jaimealbapastor/ArtBot-Drawing_Arduino_Robot/README.md

# ArtBot - Projet Arduino Peip2

Projet réalisé dans le cadre de la formation de prépa intégrée de Polytech Nice Sophia.

### Équipe:

- **Jaime Alba Pastor** ([Profil-GitHub](https://github.com/jaimealbapastor))
- **Adrien Boichis** ([Profil-GitHub](https://github.com/Adrien295))

### Tuteurs:

- **Pascal Masson**
- **M. Peter**
- **Mme. Benouakta**

## Présentation

ArtBot est un robot destiné à l'automatisation des dessins. Il peut être utilisé pour diverses taches comme par exemple:

- Impression de documents
- Illustrer
- Signer à distance
- Tracer des graphiques

Grâce l'utilisation de l'encre de stylo bic, le côut d'impression est significativement réduit ainsi que sa maintenance.
