jaimealbapastor/ArtBot-Drawing_Arduino_Robot/Documentation/Liens_utiles.md

### Projets année dernière

- https://github.com/LeoDeLaFuente/Slam_Arduino_Bot
- http://www.sofiahub.unice.fr/arduino-projet-2017-2018/

### Exemple de très haut niveau

https://www.youtube.com/watch?v=5492ZjivAQ0

### Modèle d'inspiration

https://www.arnabkumardas.com/topics/cnc/how-to-make-an-arduino-drawing-machine/
https://github.com/arnabdasbwn/grbl-coreXY-servo

### Comparaison avec CoreXY robot

http://www.doublejumpelectric.com/projects/core_xy/2014-07-15-core_xy/

### Onshape drawing machine

https://cad.onshape.com/documents/33bfda9cab8382ac132318b2/w/66322888e1b4e86c180d445c/e/0e587b7e1299ff8f6fe98d1c

## Serial communication
https://fazecast.github.io/jSerialComm/javadoc/com/fazecast/jSerialComm/SerialPort.html
https://www.tabnine.com/code/java/methods/com.fazecast.jSerialComm.SerialPort/writeBytes
https://stackoverflow.com/questions/25502517/send-string-from-java-to-arduino-simple-example
https://sourceforge.net/projects/javaarduinolibrary/
https://forum.arduino.cc/t/arduino-reset-upon-serial-java-connection/176121/4
https://forum.arduino.cc/t/stop-reboot-on-serial-connection-how/370507/5
https://playground.arduino.cc/Main/DisablingAutoResetOnSerialConnection/
