jaimealbapastor/ArtBot-Drawing_Arduino_Robot/Documentation/Matériel.md

# Matériel utilisé

## Composants

- Servo Moteurs (x2)
- Moteur pas à pas NEMA 17 (x2) --> alimenté en 12V, 20 N/cm, pas 1,8º
- Driver A4988 (x2) pour NEMA 17
- Boutons pour indicateur de limite (x4)

## Materiel à garder intacte 

- tiges en acier inoxidable 
- roulements (6, 4 sur les pièces qui bougent qur y et deux qui se situent en y = max)
- courroie dentée
- vises pour les socles 
- planche en bois

## Parties a travailler 

### Parties qui ne bougent pas 

 - socle en bois qui contient de quoi tenir les tiges en acier, tout le set up electronique en y = 0, et les deux step moteurs  qui se situent aux deux extrémités  
 - les deux socles aux extrémités en y = max 

### Parties qui bougent sur l'axe y 

- deux petits socles en bois qui bougent sur les tiges en acier grace a des roulemenrs qui sont dessus et par l'action des moteurs qui sont en y = 0 

### Parties qui bougent sur l'axe x

- socle qui va bouger avec le stylo, notament avec le system en bois qui va contenir les 4 stylos (rouge, vert, bleu, noir) et qui va bouger a la fois en hauteur pour ecrire et qui va se tourner pour changer de couleur
