jaimealbapastor/ArtBot-Drawing_Arduino_Robot/More/Useless/EXPLICATION.md

# Développement du code source avec PlatformIO

Pour ce projet on utilise le pluggin **PlatformIO** de Visual Studio Code au lieu de l'IDE Arduino.  

## Avantages
- Toutes les fonctionnalités de l'IDE Arduino sont intégrées
- Les fichiers .c++ et .h sont mieux organisés
- Permet de build et upload directement dans la plaque arduino
- Debuggeur intégré
- Donne la doc des fonctions pendant qu'on code

## Pour se retrouver
Le code principal est dans le [dossier "src"](ArtBot_Code/src) : **[main.cpp](ArtBot_Code/src/main.cpp)**  
Les classes .h et .cpp sont dans le **[dossier "include"](ArtBot_Code/include)**  
Les librairies utilisées sont dans le **[dossier "lib"](ArtBot_Code/lib)**
