jaimealbapastor/ArtBot-Drawing_Arduino_Robot/More/Modelisation_Pieces/pièce1.md

# Première pièce

[pièce y = 0](https://cad.onshape.com/documents/21a7f2e1a193b40d7dea2639/w/ac2afb2342f08798c6df94d4/e/5c67bcf19085cbfb5db68b73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)

[pièce y = max](https://cad.onshape.com/documents/21a7f2e1a193b40d7dea2639/w/ac2afb2342f08798c6df94d4/e/a18741164f335a244cec516a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)

[pièce qui bouge sur y](https://cad.onshape.com/documents/21a7f2e1a193b40d7dea2639/w/ac2afb2342f08798c6df94d4/e/8383617883dbb1d0f51e6f5b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)

[debut de l'assemblage](https://cad.onshape.com/documents/21a7f2e1a193b40d7dea2639/w/ac2afb2342f08798c6df94d4/e/ba21421cad73b33d512d3d27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)
