jaimealbapastor/ArtBot-Drawing_Arduino_Robot/Documentation/Présentation/ArtBot.pptx

## Projet ArtBot

Par Jaime Alba Pastor et Adrien Boichis

## OBJECTIFS INITIAUX

1. Pouvoir dessiner tout type de forme. Ex: graphiques, signatures…
2. Pouvoir illustrer des documents non vides pour ajouter de la valeur ou de l’information.
3. Une option moins coûteuse qu’une imprimante classique.
4. Facilement transportable.

## CIRCUIT ELECTRONIQUE ENSEMBLE MECANIQUE LE CODE CONCLUSION ET DEMO PRESENTATION DU PROJET 01 03 02 04

Modélisation, assemblage et améliorations

Composants et problèmes rencontrés

Ce que le projet nous a apporté et continuation

Idéation, méthodes principales…

## ENSEMBLE MECANIQUE

Matériel utilisé:
- Arduino Uno
- 2 Moteurs NEMA-17
- 2 Drivers A4988
- Micro Servo Moteur
- Une courroie dentée
- 6 roulements dentés
- 6 roulements à mouvement linéaire
- Visses
- Planche de bois
- Blocs de bois

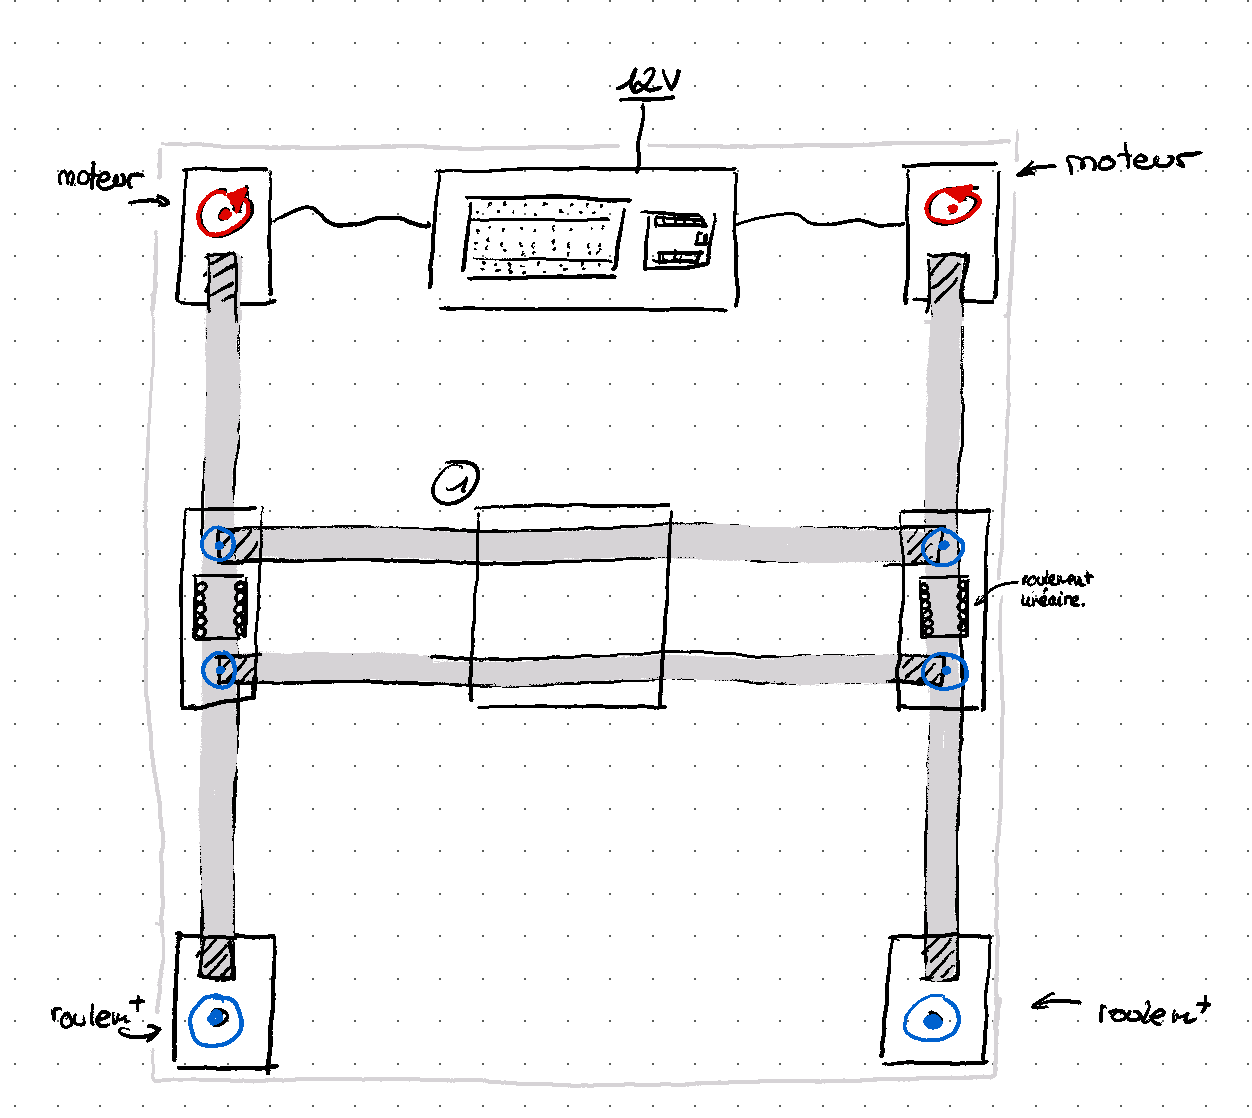
[picture p13: figure]

## FONCTIONNEMENT


## PROBLEMES RENCONTRES

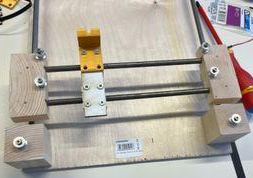
[picture p14: figure]
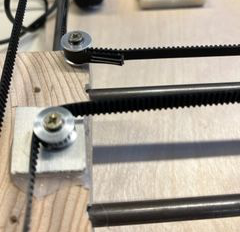
[picture p15: figure]
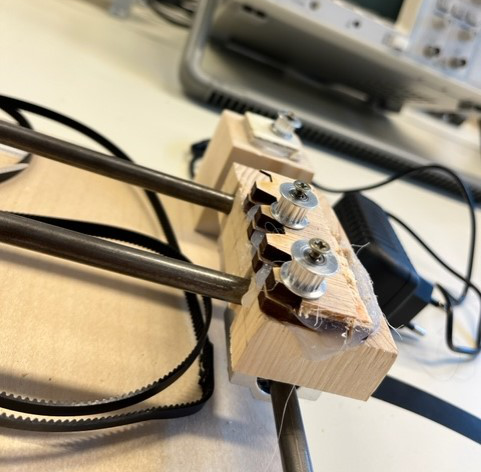
[picture p16: figure]

## CIRCUIT ELECTRONIQUE

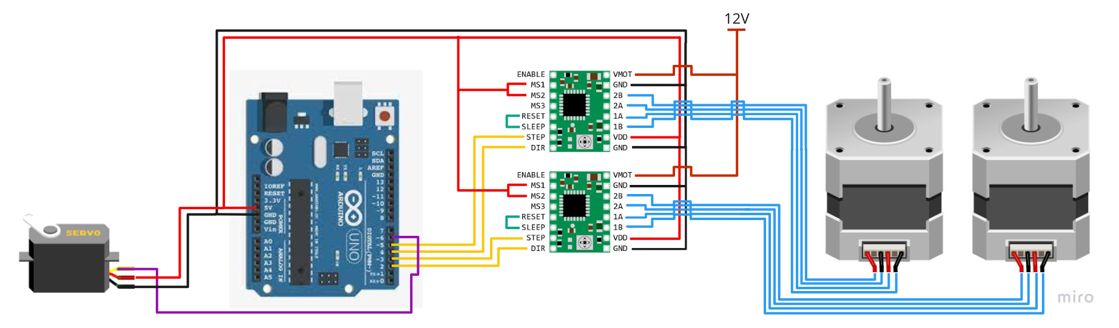
[picture p17: figure]

## LE CODE

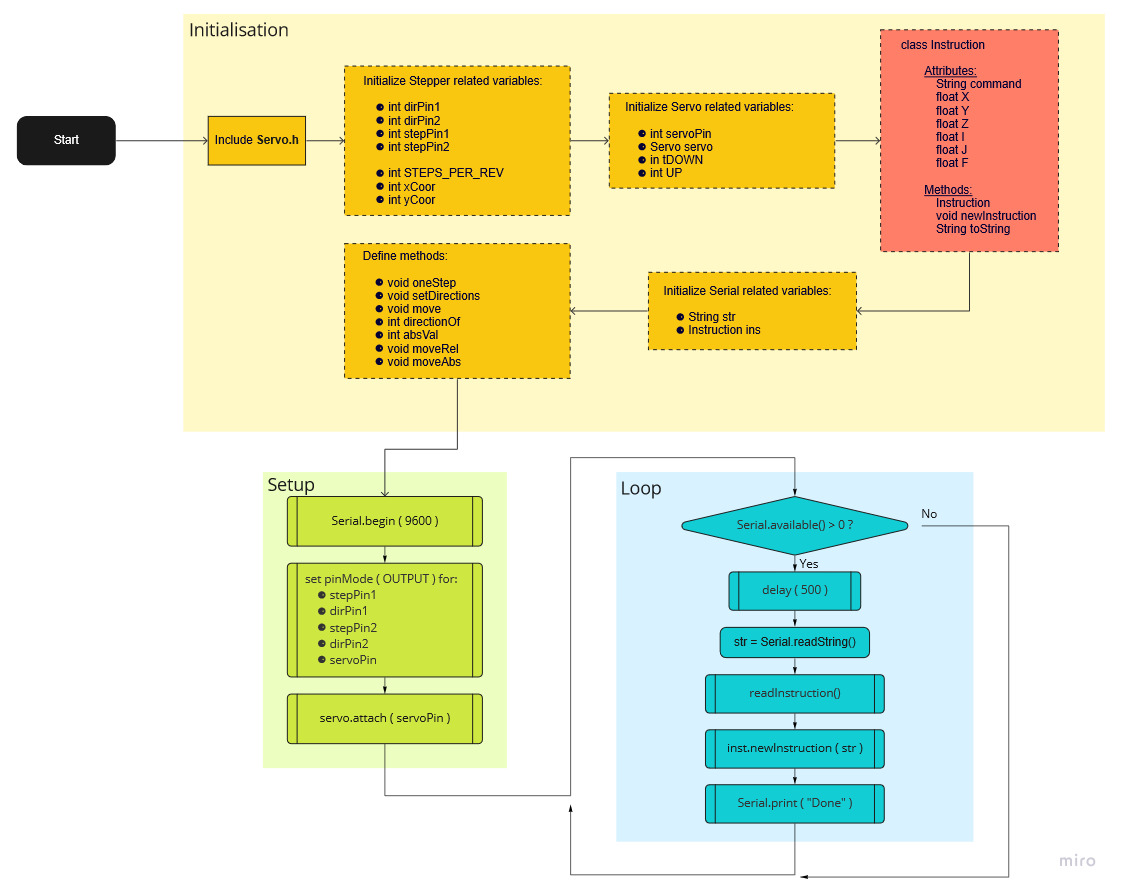
[picture p18: figure]

## Slide 9

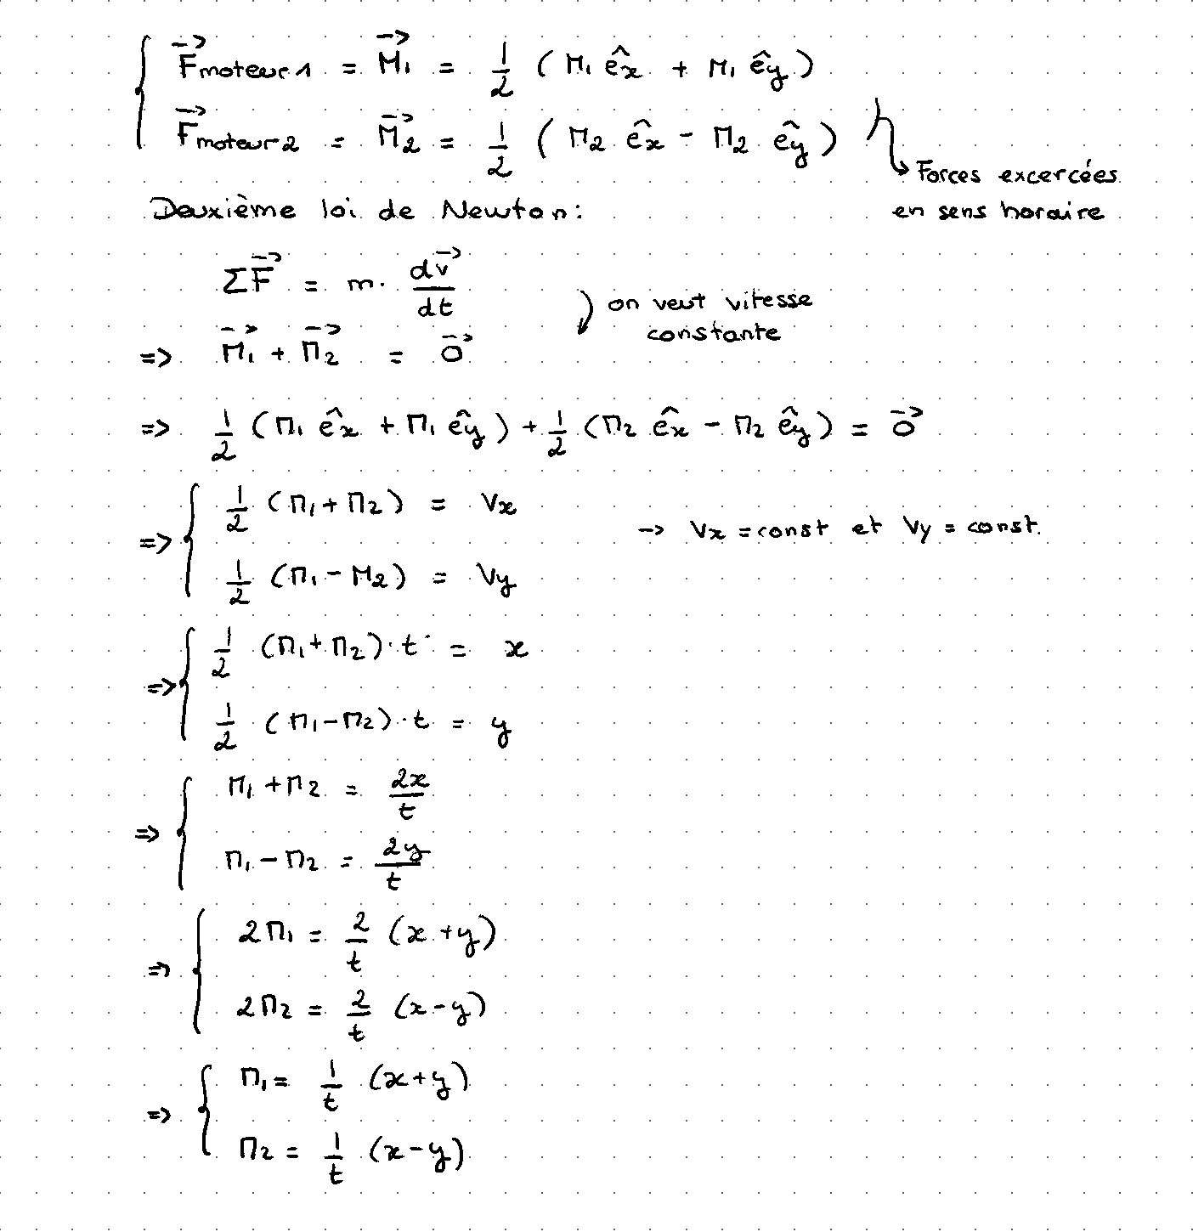
[picture p19: figure]

## APPLICATION JAVA

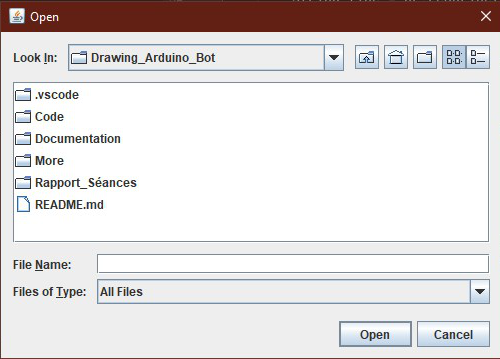
[picture p20: figure]

## Slide 11

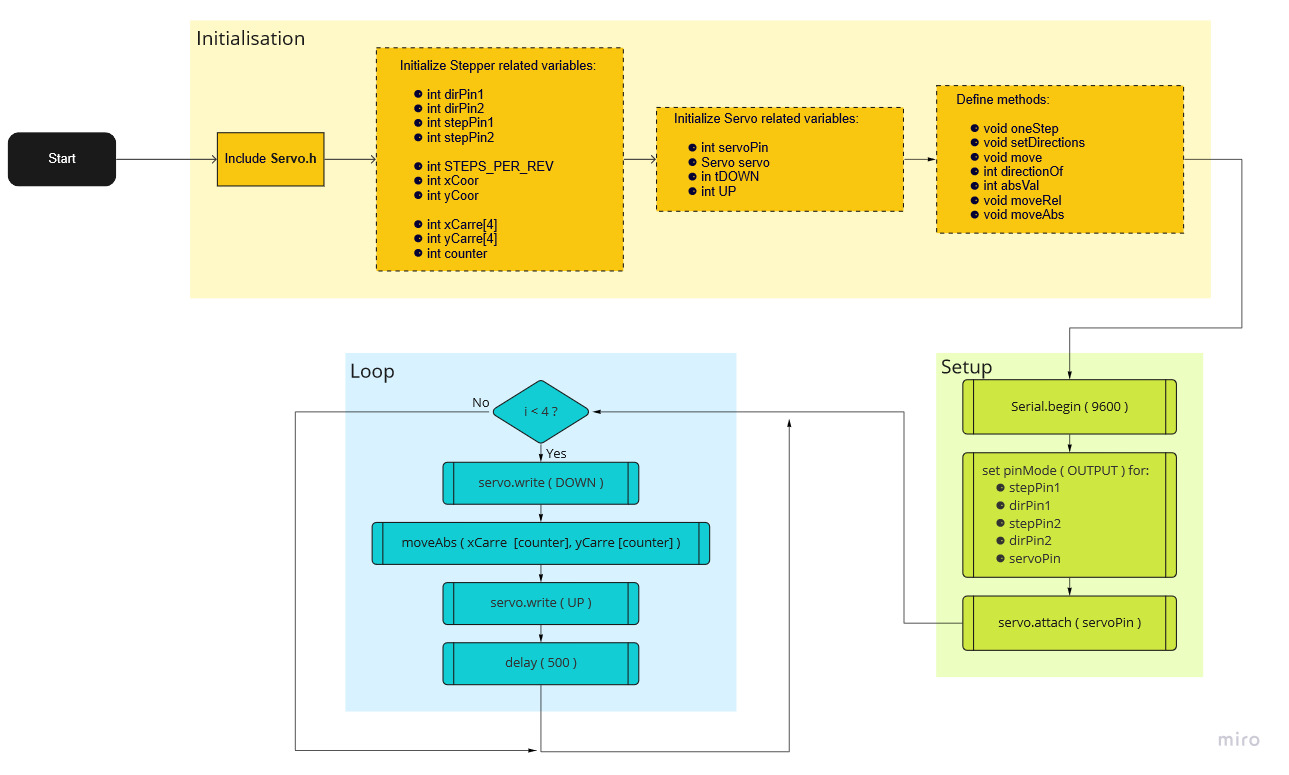
[picture p21: figure]

## MERCI DE VOTRE ATTENTION
