jaimealbapastor/ArtBot-Drawing_Arduino_Robot/Documentation/Etapes-Taches.md

# ETAPES DU PROJET & REPARTITION DES TACHES

Répartition des tâches dans **[WorkSpace ClickUp](https://sharing.clickup.com/l/h/4-32571374-1/226c80c2a30dcb4)**

# Etape 1: Planification

- [x] Trouver idée de projet
- [x] Trouver nom
- [x] Setup du GitHub

# Etape 2: Elaboration

## Partie Mécanique

- [x] Choisir type de structure
- [ ] Système pour changer les couleurs
- [x] Shematiser les pièces avant la modélisation
- [x] Modelisation des pièces
- [x] Assemblage et animation Onshape

## Partie Electronique

- [x] Shématiser le circuit
- [x] Vérifier les composants necessaires (et les lister dans [Matériel.md](Matériel.md))
- [x] Choix des moteurs
- [x] Demande d'achat des composants manquants

## Partie Programmation

- [ ] Chercher documentation

  - [ ] Librairies
  - [x] Organisation du code

- [ ] Shématiser main code
  - [ ] variables
  - [ ] principales fonctions
  - [ ] librairies
- [ ] Code pour mouvement en axes x et y

- [ ] Code pour dessiner

  - [ ] Dessiner des formes basiques
    - [ ] Contours
    - [ ] Remplissage
  - [ ] Reconnaissance d'image
    - [ ] Reconnaissance contours et couleurs
    - [ ] Convertir image en 4 couleurs

# Etape 3: Production

## Partie Mécanique / Eléctronique

- [x] Produire les pièces
- [ ] Assemblage + intégration des composants
- [ ] Créer mallette pour faciliter le transport

## Partie Programmation

- [ ] Code pour changement de couleur

- [ ] Connexion wifi/bluetooth avec telephone/ordinateur
- [ ] Application pour envoyer image

# Etape 4: Cloture du projet

- [ ] Correction des éventuels bugs

- [ ] Tests de la version finale

  - [ ] Test en noir et blanc / couleurs
  - [ ] Test document

- [ ] Rapport final
  - [ ] Evaluation du projet
  - [ ] Possibles améliorations
  - [ ] etc
