jaimealbapastor/ArtBot-Drawing_Arduino_Robot/More/Images/boites.jpg

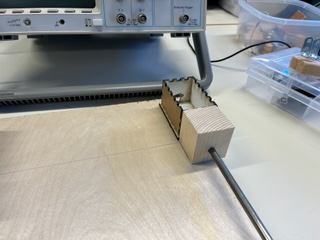
More/Images/boites.jpg
