jaimealbapastor/ArtBot-Drawing_Arduino_Robot/More/Images/IMG_8960.jpg

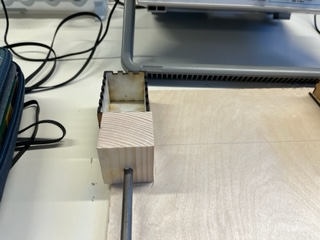
More/Images/IMG_8960.jpg
