jaimealbapastor/ArtBot-Drawing_Arduino_Robot/Code/main/carreAbs.ino

#include <Servo.h>

// =========== Constants ===========
// STEPPER MOTOR
const int dirPin1 = 2;  // Direction
const int stepPin1 = 3; // Step
const int dirPin2 = 4;
const int stepPin2 = 5;

const int STEPS_PER_REV = 210;
const int xCarre[4] = {100, 100, 0, 0};
const int yCarre[4] = {0, 100, 100, 0};
int counter = 0;

// SERVO MOTOR
const int servoPin = 6;
const int DOWN = 46;
const int UP = DOWN - 3;
Servo servo;

// COORDINATES
int xCoor = 0;
int yCoor = 0;

// =========== oneStep ===========
void oneStep(int pin)
{
    digitalWrite(pin, HIGH);
    delayMicroseconds(1000);
    digitalWrite(pin, LOW);
    delayMicroseconds(1000);
}

// =========== setDirections ===========
void setDirections(int direction1, int direction2)
{
    digitalWrite(dirPin1, direction1);
    digitalWrite(dirPin2, direction2);
}

// =========== Move ===========
void move(int steps1, int steps2)
// Perform a uniform frecuence depending on the ration between both steps
{
    int bigNbSteps;
    int bigPin;
    int littleNbSteps;
    int littlePin;

    if (steps1 <= steps2)
    {
        bigNbSteps = steps2;
        bigPin = stepPin2;
        littleNbSteps = steps1 + 1;
        littlePin = stepPin1;
    }
    else
    {
        bigNbSteps = steps1;
        bigPin = stepPin1;
        littleNbSteps = steps2 + 1;
        littlePin = stepPin2;
    }

    const int quotient = bigNbSteps / littleNbSteps;
    const float rest = float(bigNbSteps % littleNbSteps) / littleNbSteps;
    float restCount = 0.0;

    for (int i = 0; i < littleNbSteps; i++)
    {
        oneStep(littlePin);
        for (int j = 0; j < quotient; j++)
        {
            oneStep(bigPin);

            restCount += rest;
            if (restCount >= 1)
            {
                oneStep(bigPin);
                restCount -= 1;
            }
        }
    }
}

// =========== directionOf ===========
int directionOf(int x)
{
    if (x < 0)
    {
        return 0;
    }
    return 1;
}

// =========== absVal ===========
int absVal(int x)
{
    if (x < 0)
    {
        return x * (-1);
    }
    return x;
}

// =========== moveRel ===========
void moveRel(int x, int y)
{
    int nbSteps1 = 2 * (x + y);
    int nbSteps2 = 2 * (x - y);

    setDirections(directionOf(nbSteps1), directionOf(nbSteps2));
    move(absVal(nbSteps1), absVal(nbSteps2));
}

// =========== moveAbs ===========
void moveAbs(int x, int y)
{
    moveRel(x - xCoor, y - yCoor);
    xCoor = x;
    yCoor = y;
}

// =========== SETUP ===========
void setup()
{
    Serial.begin(9600);

    // STEPPER MOTOR
    pinMode(stepPin1, OUTPUT);
    pinMode(dirPin1, OUTPUT);

    pinMode(stepPin2, OUTPUT);
    pinMode(dirPin2, OUTPUT);

    // SERVO MOTOR
    pinMode(servoPin, OUTPUT);
    servo.attach(servoPin);
}
// =========== LOOP ===========
void loop()
{
    if (counter < 4)
    {
        servo.write(DOWN);
        moveAbs(xCarre[counter], yCarre[counter]);
        servo.write(UP);
        delay(500);
    }
}
