jaimealbapastor/ArtBot-Drawing_Arduino_Robot/(commit log)

2021-11-14 Github organisation setup
    Création des dossiers du github
    Début du readme et cahier des charges
2021-11-28 cahier des charges
2021-11-28 Etapes
    Organiser la repartition des taches
2021-12-02 verification pour rendu de scéance 1
2022-02-24 main frame
